Domy-MANS/MANS/hardware/mechanical/SLDASM/电机.SLDPRT

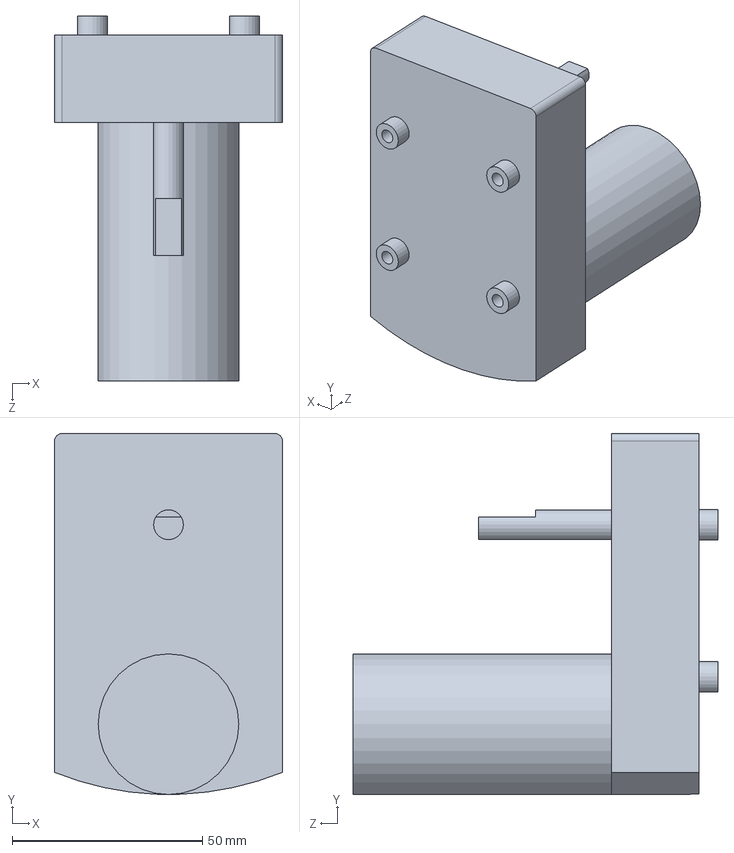
[picture p11: CAD file, 2026-11-01]
hardware/mechanical/SLDASM/电机.SLDPRT
60.0 x 95.0 x 96.0 mm
