Domy-MANS/MANS/hardware/mechanical/STEP/大臂绑缚_2.STEP

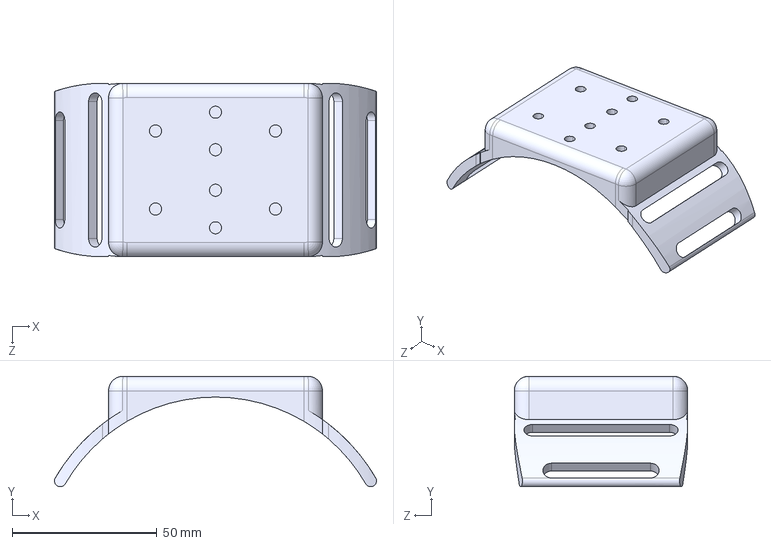
[picture p12: CAD file, 2026-11-01]
hardware/mechanical/STEP/大臂绑缚_2.STEP
111.4 x 38.2 x 60.0 mm
