Domy-MANS/MANS/hardware/mechanical/打印/大臂绑缚.3mf

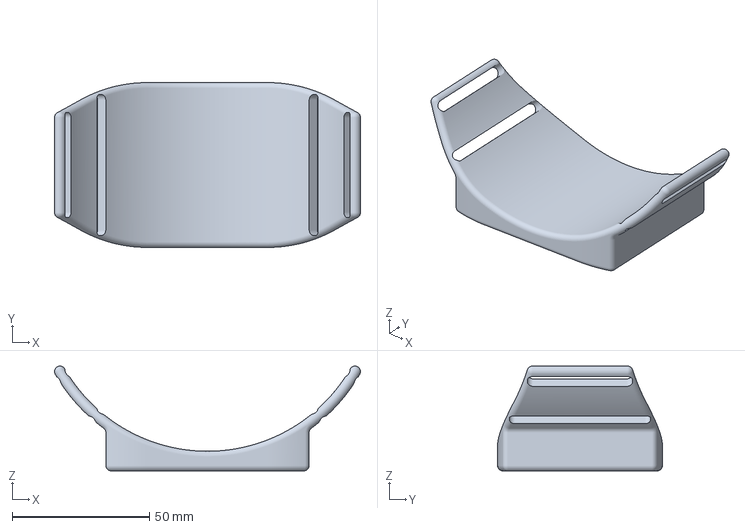
[picture p13: CAD file, 2026-11-01]
hardware/mechanical/打印/大臂绑缚.3mf
111.4 x 60.0 x 38.2 mm
