Domy-MANS/MANS/hardware/mechanical/打印/滑槽 - 小臂.3mf

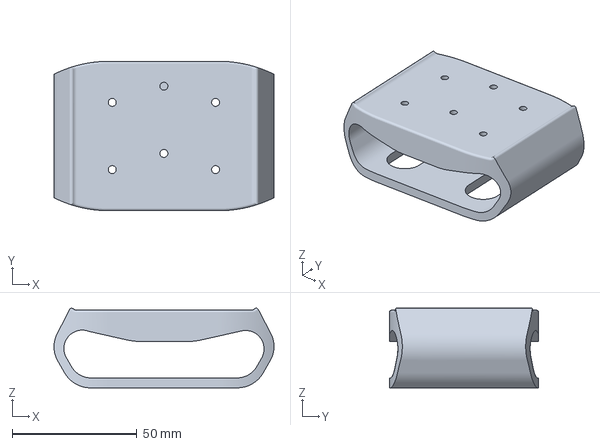
[picture p14: CAD file, 2026-11-01]
hardware/mechanical/打印/滑槽 - 小臂.3mf
88.3 x 60.0 x 32.0 mm
