Domy-MANS/MANS/hardware/mechanical/编码器校准件.STEP

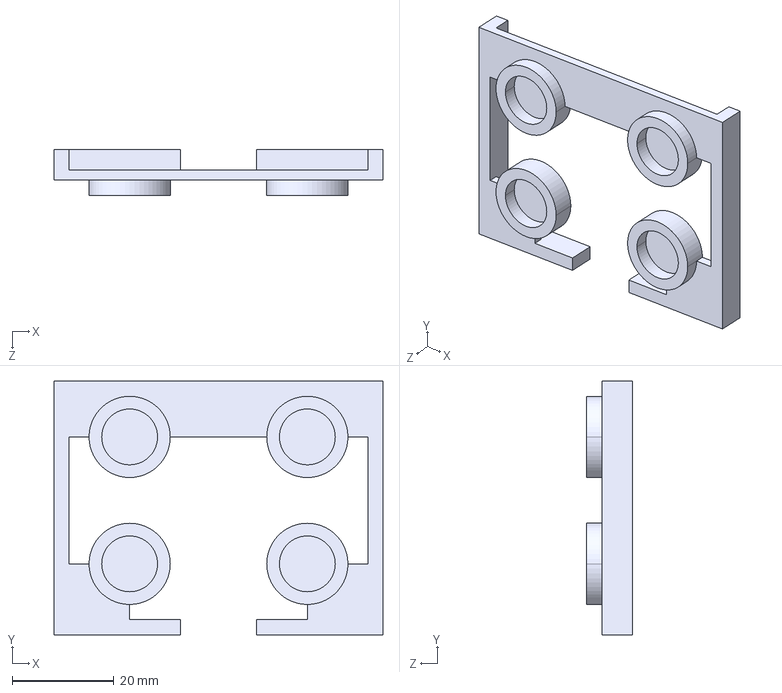
[picture p15: CAD file, 2026-11-01]
hardware/mechanical/编码器校准件.STEP
64.8 x 50.0 x 9.00 mm
