Domy-MANS/MANS/hardware/mechanical/SLDASM/舵盘.SLDPRT

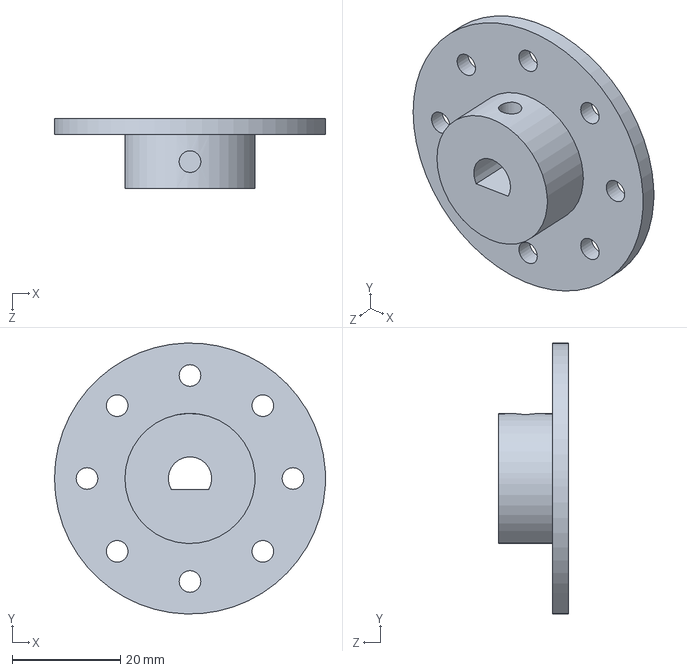
[picture p16: CAD file, 2026-11-01]
hardware/mechanical/SLDASM/舵盘.SLDPRT
50.0 x 50.0 x 13.0 mm
