Domy-MANS/MANS/hardware/mechanical/STEP/固定件v2.STEP

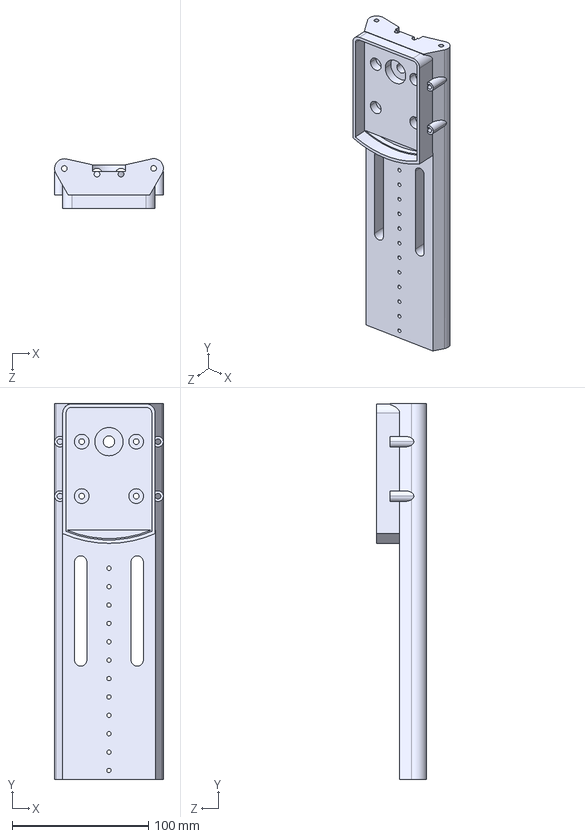
[picture p17: CAD file, 2026-11-01]
hardware/mechanical/STEP/固定件v2.STEP
79.9 x 276.1 x 36.6 mm
