Domy-MANS/MANS/hardware/mechanical/打印/固定件v2.3mf

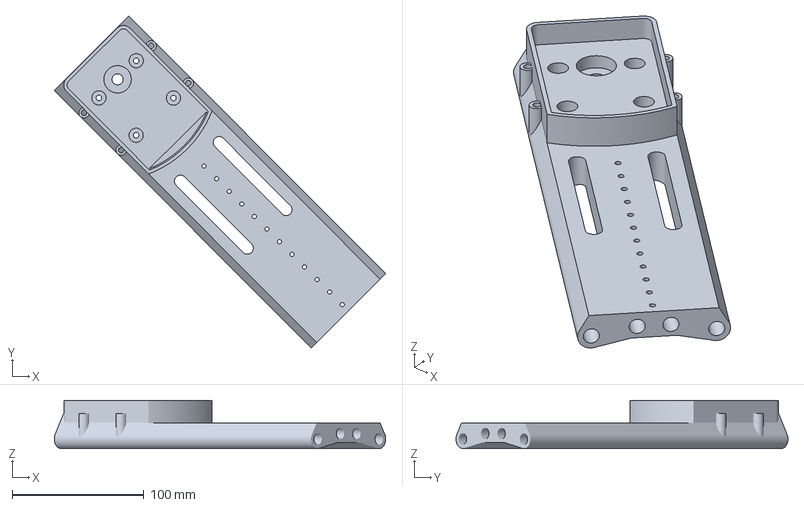
[picture p18: CAD file, 2026-11-01]
hardware/mechanical/打印/固定件v2.3mf
251.5 x 252.0 x 36.6 mm
