Domy-MANS/MANS/hardware/mechanical/SLDASM/8mm碳纤维管.SLDPRT

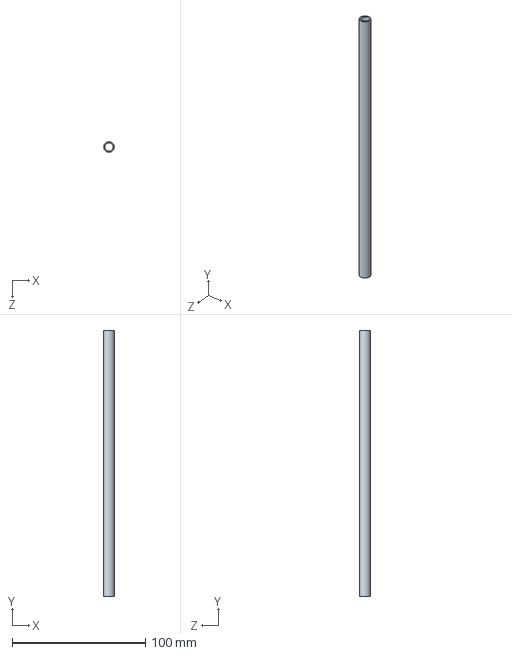
[picture p19: CAD file, 2026-11-01]
hardware/mechanical/SLDASM/8mm碳纤维管.SLDPRT
8.00 x 200.0 x 8.00 mm
