Domy-MANS/MANS/hardware/mechanical/STEP/固定件.STEP

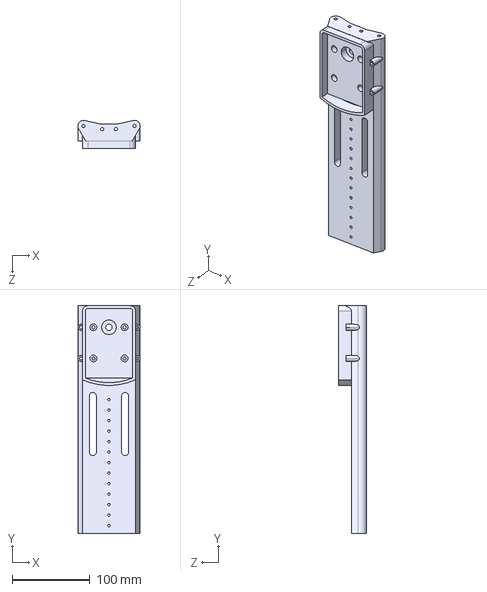
[picture p20: CAD file, 2026-11-01]
hardware/mechanical/STEP/固定件.STEP
79.9 x 293.0 x 36.6 mm
