Domy-MANS/MANS/hardware/mechanical/SLDASM/舵机2022系列.SLDPRT

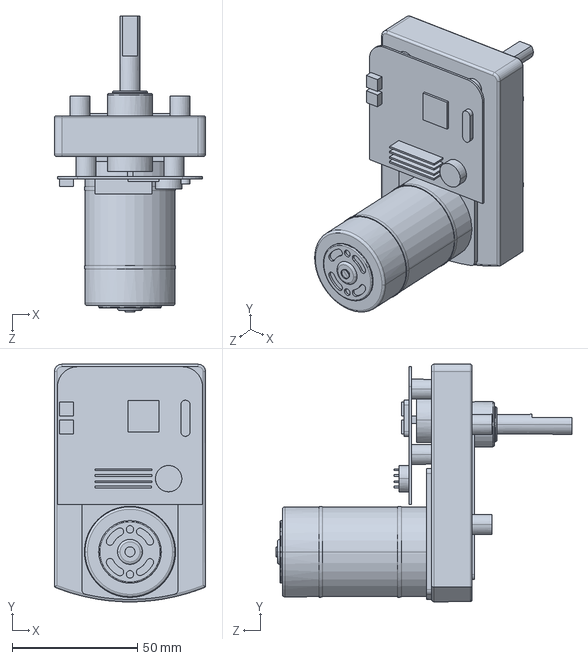
[picture p21: CAD file, 2026-11-01]
hardware/mechanical/SLDASM/舵机2022系列.SLDPRT
60.5 x 95.0 x 118.3 mm
