Domy-MANS/MANS/hardware/mechanical/STEP/小臂.STEP

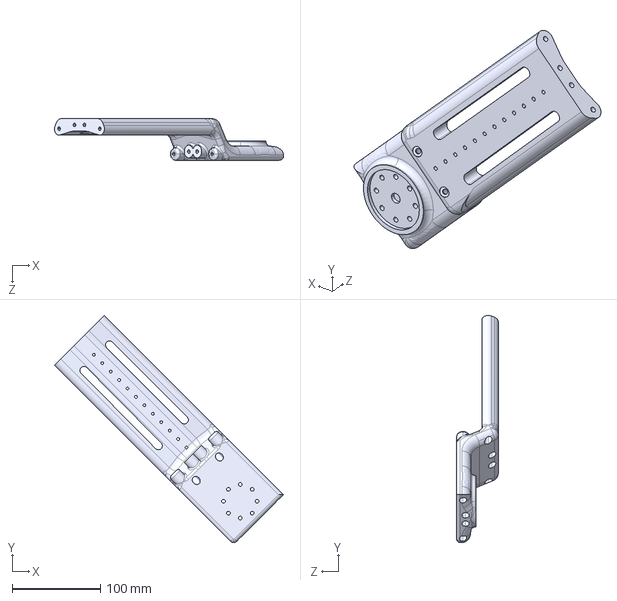
[picture p22: CAD file, 2026-11-01]
hardware/mechanical/STEP/小臂.STEP
259.4 x 257.3 x 47.3 mm
