Domy-MANS/MANS/hardware/mechanical/STEP/小臂绑缚.STEP

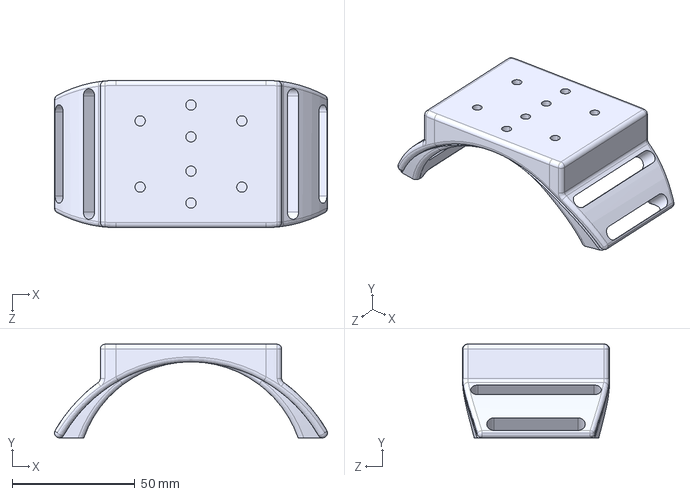
[picture p23: CAD file, 2026-11-01]
hardware/mechanical/STEP/小臂绑缚.STEP
111.4 x 38.2 x 60.0 mm
