Domy-MANS/MANS/hardware/mechanical/装配体-可动.SLDASM

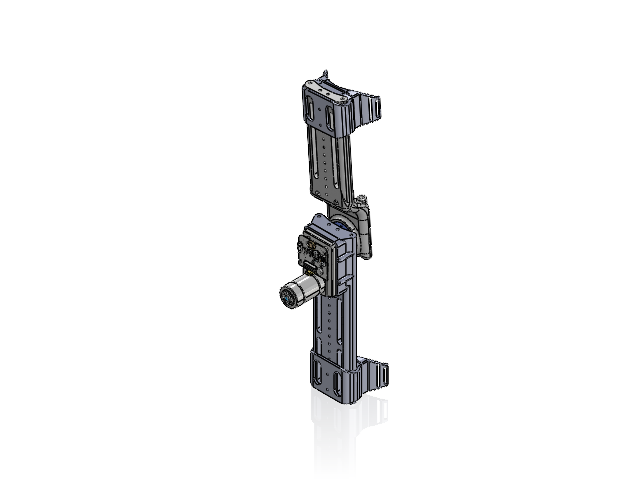
[picture p24: CAD file, 2026-11-01]
hardware/mechanical/装配体-可动.SLDASM
舵机2022系列
大臂绑缚 x 2
固定件
滑槽
舵盘
滑槽 - 小臂
小臂
pcb1
