Domy-MANS/MANS/hardware/mechanical/装配体1.SLDASM

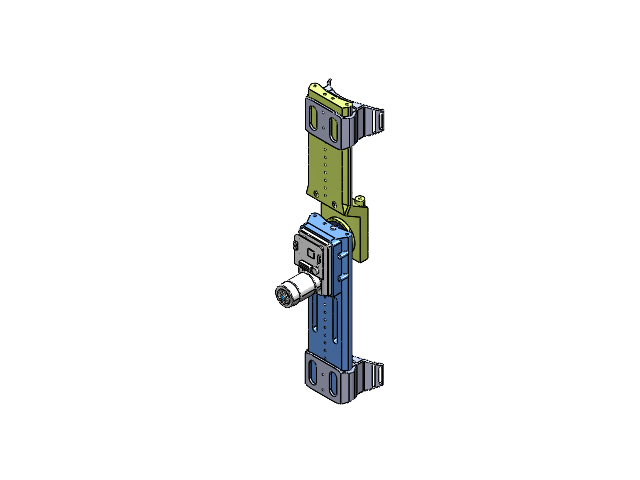
[picture p25: CAD file, 2026-11-01]
hardware/mechanical/装配体1.SLDASM
舵机2022系列
大臂绑缚 x 2
固定件
m4X12螺丝 x 2
舵盘
8mm碳纤维管 x 4
零件1^装配体1
滑槽
小臂
滑槽 - 小臂
