Domy-MANS/MANS/(list of files, cad)

Other CAD files:
hardware/mechanical/STEP/大臂绑缚.STEP
hardware/mechanical/pcb1.SLDPRT
hardware/mechanical/打印/滑槽.3mf
hardware/mechanical/STEP/滑槽 - 小臂.STEP
hardware/mechanical/STEP/滑槽.STEP
hardware/mechanical/STEP/大臂绑缚_1.STEP
hardware/mechanical/SLDASM/m4X12螺丝.SLDPRT
hardware/mechanical/SLDASM/固定件.SLDPRT
hardware/mechanical/SLDASM/固定件v2.SLDPRT
hardware/mechanical/SLDASM/大臂绑缚.SLDPRT
hardware/mechanical/SLDASM/大臂绑缚_2.SLDPRT
hardware/mechanical/SLDASM/小臂.SLDPRT
hardware/mechanical/SLDASM/滑槽 - 小臂.SLDPRT
hardware/mechanical/SLDASM/滑槽.SLDPRT
hardware/mechanical/STEP/固定件.SLDPRT
hardware/mechanical/STEP/大臂绑缚.SLDPRT
hardware/mechanical/STEP/大臂绑缚_1.SLDPRT
hardware/mechanical/STEP/小臂.SLDPRT
hardware/mechanical/STEP/小臂绑缚.SLDPRT
hardware/mechanical/STEP/滑槽 - 小臂.SLDPRT
hardware/mechanical/STEP/滑槽.SLDPRT
