Domy-MANS/MANS/(list of files, drawings)

Other design files:
hardware/pcb/01 POW.SchDoc
hardware/pcb/02 MCU.SchDoc
hardware/pcb/03 DRV.SchDoc
hardware/pcb/04 Sensing.SchDoc
hardware/pcb/PCB1.PcbDoc
hardware/pcb/PCB_Project.PrjPcb
