Domy-MANS/MANS/(commit log)

2026-11-01 Add the MANS elbow exoskeleton prototype
    Firmware, PCB and mechanical design of the first hardware prototype.
    [01 POW.SchDoc, 02 MCU.SchDoc, 03 DRV.SchDoc, 04 Sensing.SchDoc, 8mm碳纤维管.SLDPRT, PCB1.PcbDoc, PCB_Project.PrjPcb, m4X12螺丝.SLDPRT]
2026-11-01 Show the schematics in the README
